nunosousa/DC_VGA_Adapter/README.md

# DC_VGA_Adapter
This is a project detailing a Dreamcast VGA circuit adapter to provide VGA video output.
