nunosousa/DC_VGA_Adapter/Hardware/3D Assembly/Dreamcast_VGA_Adapter.FCStd

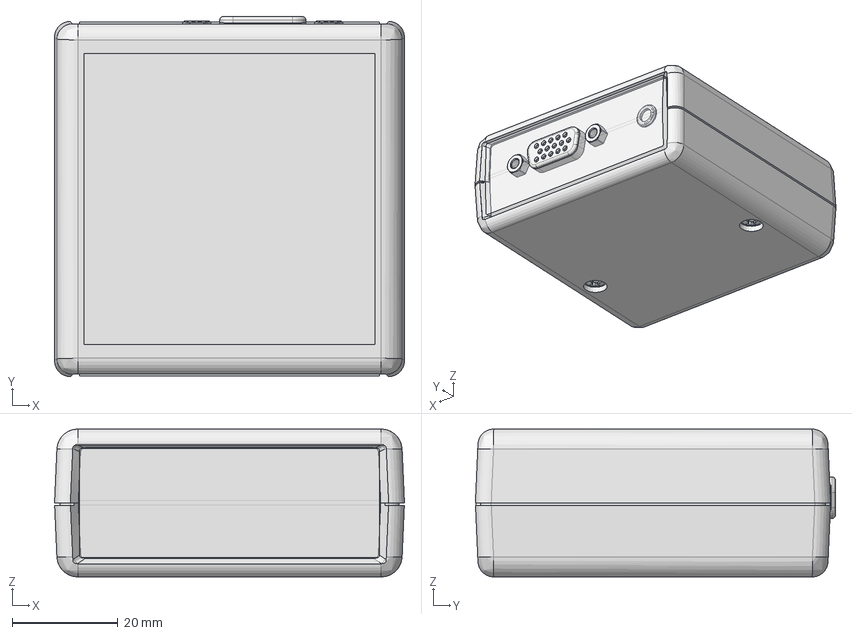
[picture p1: CAD file, 2020-10-10]
Hardware/3D Assembly/Dreamcast_VGA_Adapter.FCStd
66.2 x 68.2 x 28.0 mm
1593K BOTTOM
1593K Top
1593K-L-P-Q-X-Y Flat endplate
1593K-L-P-Q-X-Y Flat endplate001
1593K-L-P-Q-X-Y Contoured Endplate
1593K-L-P-Q-X-Y Contoured Endplate001
SC549 (screw #4X 3_4' OH)
SC549 (screw #4X 3_4' OH)001
1593K PCB
Pcb_5eb8
J1_CUI_DEVICES_SJ1_3533NG_5F7F81FF[2]
U2_SOT_363_SC_70_6_5F7EE279
U1_SOIC_8_39x49mm_P127mm_5F80D54B
SW1_SW_DIP_SPSTx02_Slide_978x726mm_W762mm_P254mm_5F7EE249
R16_R_0805_2012Metric_5F7EE1F0
R15_R_0805_2012Metric_5F7EE1DF
R11_R_0805_2012Metric_5F7EE19B
R10_R_0805_2012Metric_5F7EE18A
R9_R_0805_2012Metric_5F7EE179
R8_R_0805_2012Metric_5F7EE168
R7_R_0805_2012Metric_5F7EE157
R6_R_0805_2012Metric_5F81AA12
R5_R_0805_2012Metric_5F7EE135
R4_R_0805_2012Metric_5F7EE124
R3_R_0805_2012Metric_5F80C6F6
R2_R_0805_2012Metric_5F7FEECB
R1_R_0805_2012Metric_5F7EE0F1
J3_IDC_Header_2x08_P254mm_Vertical_5F7EE0E0
J2_K61X-E15S-NJ_rA4_5F7EE0B2
FB1_L_0805_2012Metric_5F7EE05C
C21_C_0805_2012Metric_5F7EE04B
C20_C_0805_2012Metric_5F7EE03A
C19_C_0805_2012Metric_5F7EE029
C18_C_0805_2012Metric_5F7EE018
C17_C_0805_2012Metric_5F7EE007
C16_C_0805_2012Metric_5F7EDFF6
C15_C_0805_2012Metric_5F7EDFE5
C11_C_0805_2012Metric_5F7EDFA1
C10_C_0805_2012Metric_5F7EDF90
C9_C_0805_2012Metric_5F7EDF7F
C8_CP_EIA_3528_21_Kemet_B_5F818F46
C7_C_0805_2012Metric_5F7EDF5B
C3_CP_Radial_D80mm_P350mm_5F7FE0AD
C2_CP_Radial_D80mm_P350mm_5F7FEB00
C1_CP_Radial_D80mm_P350mm_5F7FE8D8
R14_R_0805_2012Metric_5F7EE1CE
R13_R_0805_2012Metric_5F7EE1BD
R12_R_0805_2012Metric_5F7EE1AC
C6_C_0805_2012Metric_5F7FE810
C5_C_0805_2012Metric_5F7FEA38
C4_C_0805_2012Metric_5F7FE7E0
