nunosousa/DC_VGA_Adapter/Hardware/3D Assembly/1593K.stp

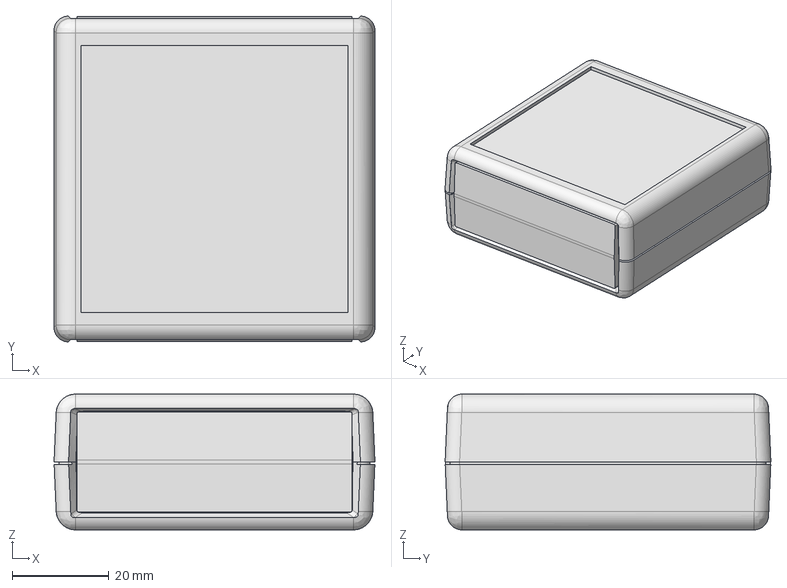
[picture p2: CAD file, 2020-10-10]
Hardware/3D Assembly/1593K.stp
66.2 x 67.2 x 28.0 mm
1593K BOTTOM
1593K Top
1593K-L-P-Q-X-Y Flat endplate x 2
1593K-L-P-Q-X-Y Contoured Endplate x 2
1593K PCB
