nunosousa/DC_VGA_Adapter/Hardware/3D Assembly/holes.pdf

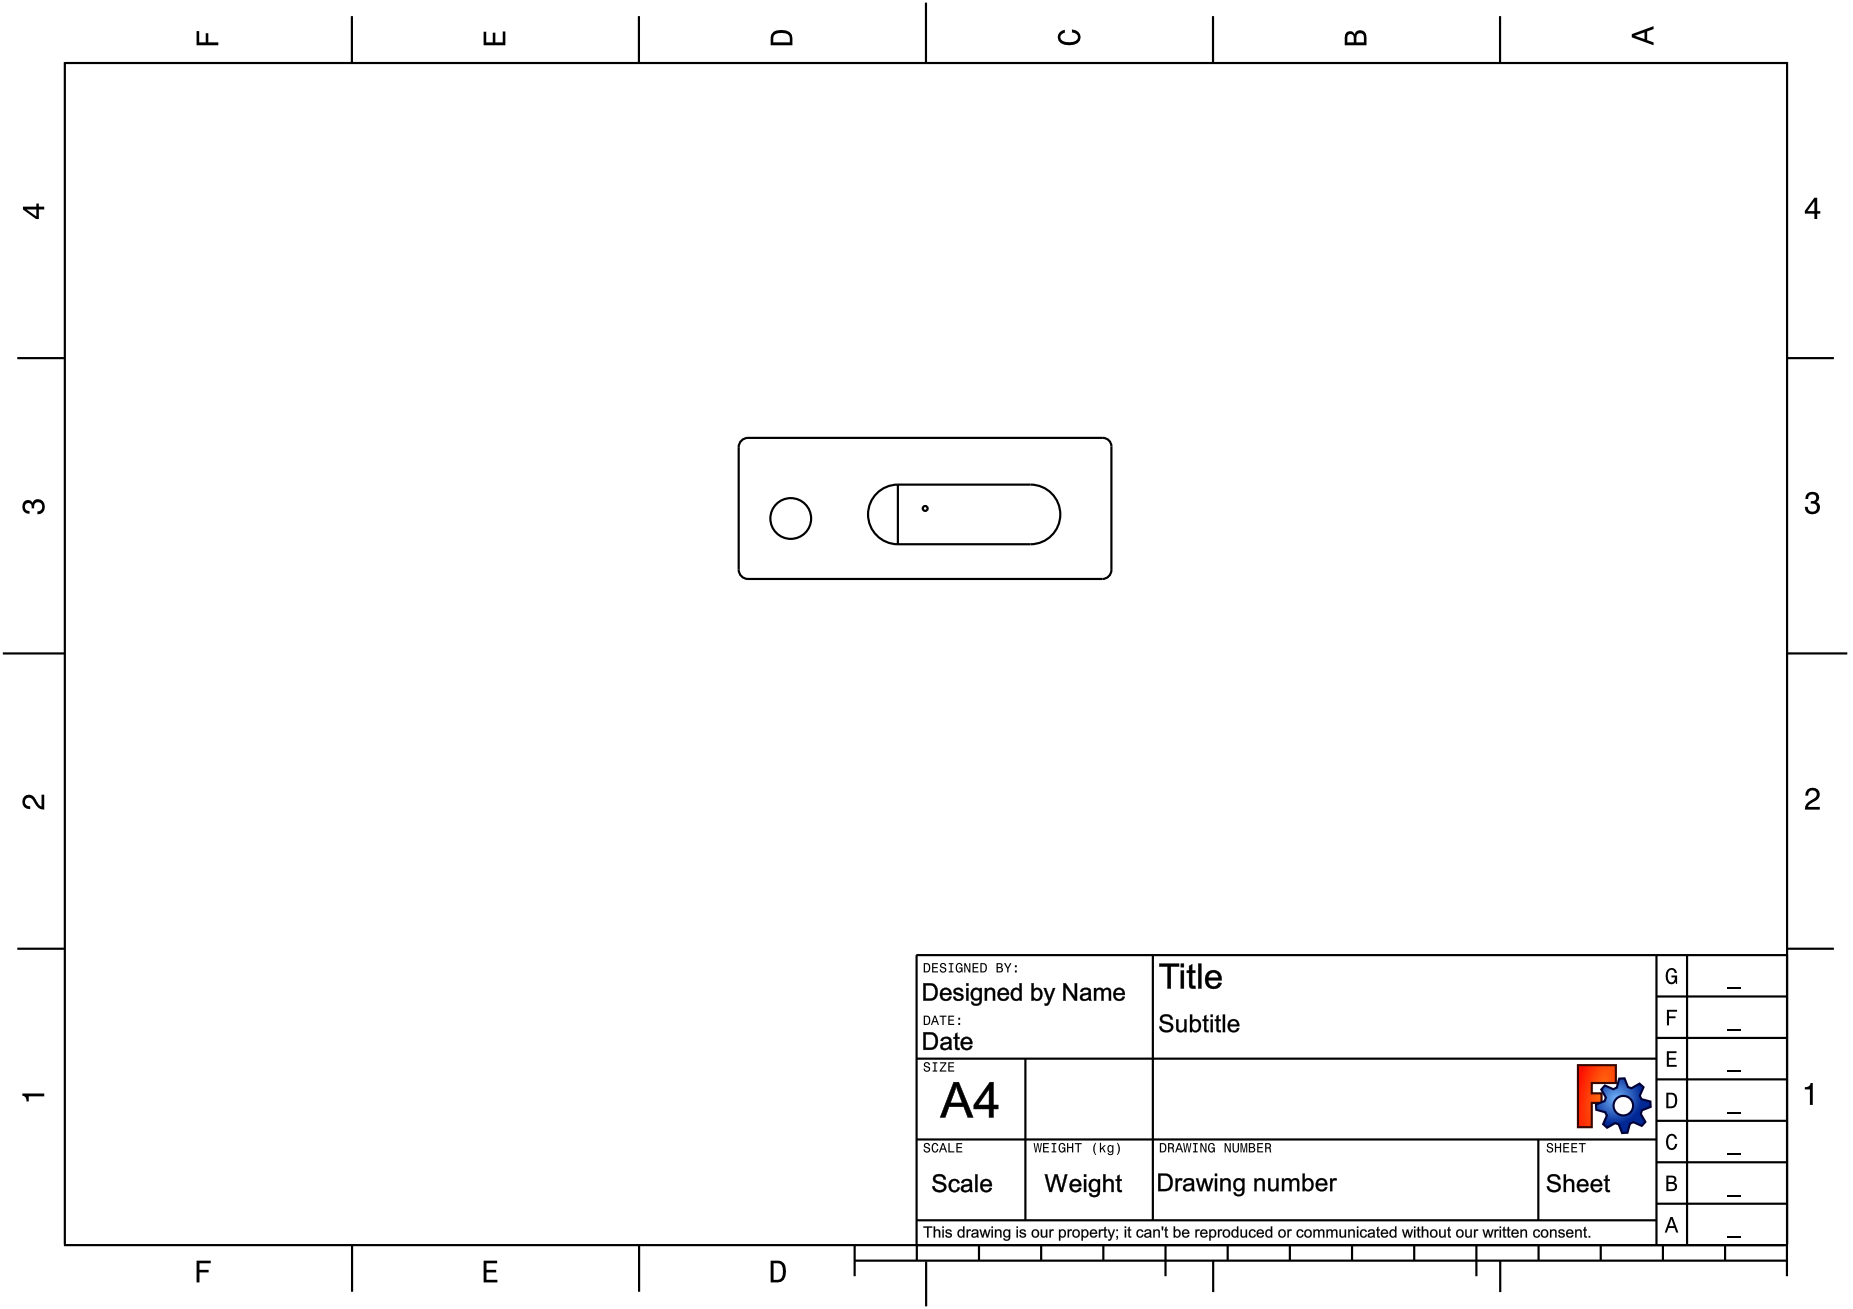
[picture p3: page 1]
