nunosousa/DC_VGA_Adapter/Hardware/Dreamcast_VGA_Adapter.kicad_pcb

## KiCad design Hardware/Dreamcast_VGA_Adapter.kicad_pcb (2024-04-14)

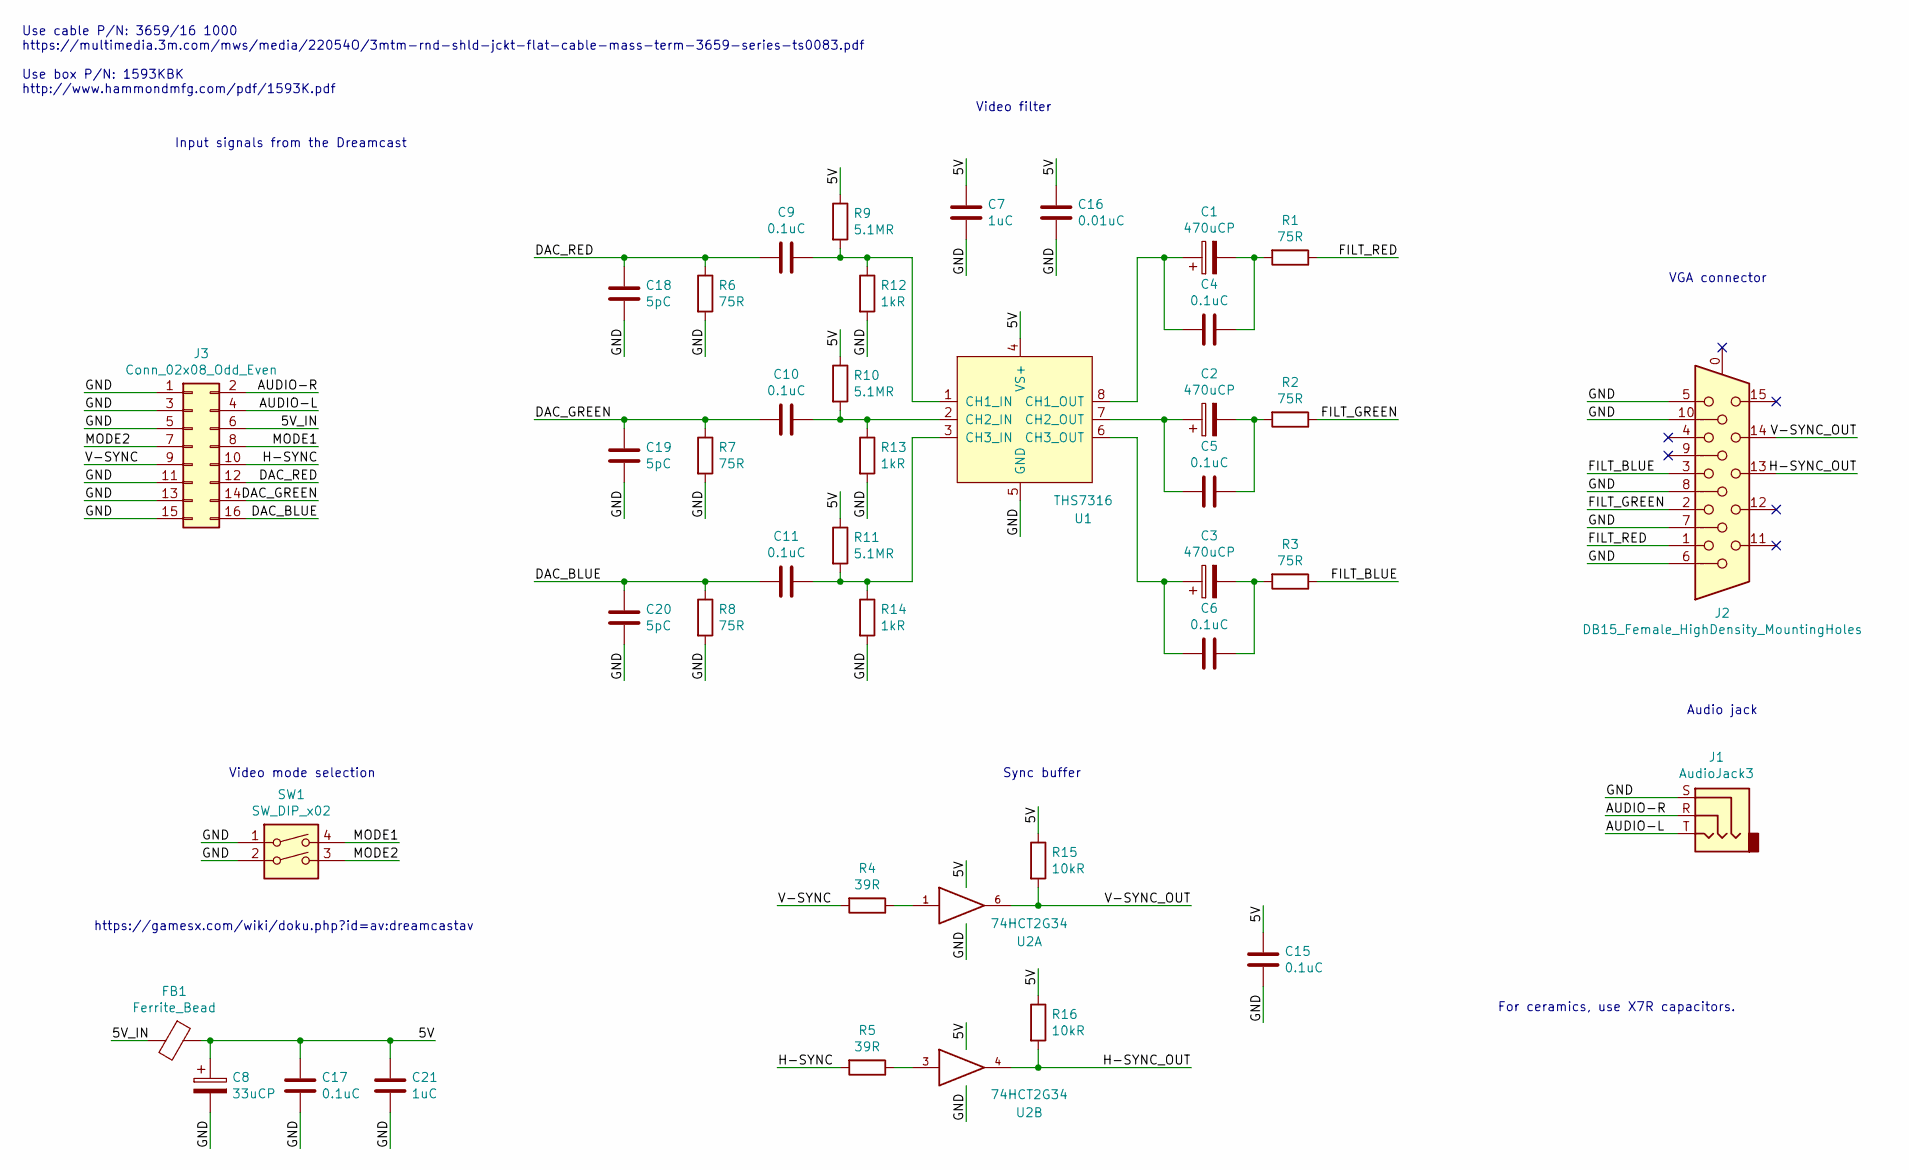
[picture p4: schematic Dreamcast_VGA_Adapter.kicad_sch]

Parts:
C1, C2, C3: 470uCP; CP_Radial_D8.0mm_P3.50mm; Manufacturer Part Number 16ZLH470MEFCT78X11.5
C4, C5, C6, C9, C10, C11, C15, C17: 0.1uC; C_0805_2012Metric_Pad1.15x1.40mm_HandSolder; Manufacturer Part Number AC0805KRX7R7BB104
C7, C21: 1uC; C_0805_2012Metric_Pad1.15x1.40mm_HandSolder; Manufacturer Part Number CC0805MKX7R7BB105
C8: 33uCP; CP_EIA-3528-21_Kemet-B_Pad1.50x2.35mm_HandSolder; Manufacturer Part Number TAJB336K006RNJ
C16: 0.01uC; C_0805_2012Metric_Pad1.15x1.40mm_HandSolder; Manufacturer Part Number CC0805KRX7R9BB103
C18, C19, C20: 5pC; C_0805_2012Metric_Pad1.15x1.40mm_HandSolder; Manufacturer Part Number 08055A5R0CAT2A
FB1: Ferrite_Bead; L_0805_2012Metric_Pad1.15x1.40mm_HandSolder; Manufacturer Part Number BLM21SP471SH1D
J1: AudioJack3; Jack_3.5mm_CUI_SJ1-3533NG_Horizontal; Manufacturer Part Number SJ1-3533NG
J2: DB15_Female_HighDensity_MountingHoles; DSUB-15-HD_Female_Horizontal_P2.29x1.98mm_EdgePinOffset3.03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; Manufacturer Part Number K61X-E15S-NJ
J3: Conn_02x08_Odd_Even; IDC-Header_2x08_P2.54mm_Vertical; Manufacturer Part Number 7816-0000PR
R1, R2, R3, R6, R7, R8: 75R; R_0805_2012Metric_Pad1.15x1.40mm_HandSolder; Manufacturer Part Number KTR10EZPF75R0
R4, R5: 39R; R_0805_2012Metric_Pad1.15x1.40mm_HandSolder; Manufacturer Part Number RC0805FR-0739RL
R9, R10, R11: 5.1MR; R_0805_2012Metric_Pad1.15x1.40mm_HandSolder; Manufacturer Part Number KTR10EZPF5104
R12, R13, R14: 1kR; R_0805_2012Metric_Pad1.15x1.40mm_HandSolder; Manufacturer Part Number RC0805FR-071KL
R15, R16: 10kR; R_0805_2012Metric_Pad1.15x1.40mm_HandSolder; Manufacturer Part Number RC0805FR-0710KL
SW1: SW_DIP_x02; SW_DIP_SPSTx02_Slide_9.78x7.26mm_W7.62mm_P2.54mm; Manufacturer Part Number DS01-254-L-02BE
U1: THS7316; SOIC-8_3.9x4.9mm_P1.27mm; Manufacturer Part Number THS7316DR
U2: 74HCT2G34; SOT-363_SC-70-6_Handsoldering; Manufacturer Part Number 74HCT2G34GW,125

Connections:
/5V_IN: FB1.2, J3.6
/AUDIO-L: J1.T, J3.4
/AUDIO-R: J1.R, J3.2
/DAC_BLUE: C11.2, C20.1, J3.16, R8.1
/DAC_GREEN: C10.2, C19.1, J3.14, R7.1
/DAC_RED: C9.2, C18.1, J3.12, R6.1
/FILT_BLUE: J2.3, R3.1
/FILT_GREEN: J2.2, R2.1
/FILT_RED: J2.1, R1.1
/H-SYNC: J3.10, R5.2
/H-SYNC_OUT: J2.13, R16.2, U2.4
/MODE1: J3.8, SW1.4
/MODE2: J3.7, SW1.3
/V-SYNC: J3.9, R4.2
/V-SYNC_OUT: J2.14, R15.2, U2.6
GND: C7.2, C8.2, C15.2, C16.2, C17.2, C18.2, C19.2, C20.2, C21.2, J1.S, J2.5, J2.6, J2.7, J2.8, J2.10, J3.1, J3.3, J3.5, J3.11, J3.13, J3.15, R6.2, R7.2, R8.2, R12.2, R13.2, R14.2, SW1.1, SW1.2, U1.5 (GND), U2.2 (GND)
unnamed: C1.1, C4.2, U1.8 (CH1_OUT)
unnamed: C1.2, C4.1, R1.2
unnamed: C2.1, C5.2, U1.7 (CH2_OUT)
unnamed: C2.2, C5.1, R2.2
unnamed: C3.1, C6.2, U1.6 (CH3_OUT)
unnamed: C3.2, C6.1, R3.2
unnamed: C9.1, R9.2, R12.1, U1.1 (CH1_IN)
unnamed: C10.1, R10.2, R13.1, U1.2 (CH2_IN)
unnamed: C11.1, R11.2, R14.1, U1.3 (CH3_IN)
unnamed: R4.1, U2.1
unnamed: R5.1, U2.3
VCC: C7.1, C8.1, C15.1, C16.1, C17.1, C21.1, FB1.1, R9.1, R10.1, R11.1, R15.1, R16.1, U1.4 (VS+), U2.5 (VCC)

Notes on the sheet:
Video mode selection
Video filter
For ceramics, use X7R capacitors.
Audio jack
Use cable P/N: 3659/16 1000 https://multimedia.3m.com/mws/media/22054O/3mtm-rnd-shld-jckt-flat-cable-mass-term-3659-series-ts0083.pdf Use box P/N: 1593KBK http://www.hammondmfg.com/pdf/1593K.pdf
Sync buffer
Input signals from the Dreamcast
https://gamesx.com/wiki/doku.php?id=av:dreamcastav
VGA connector

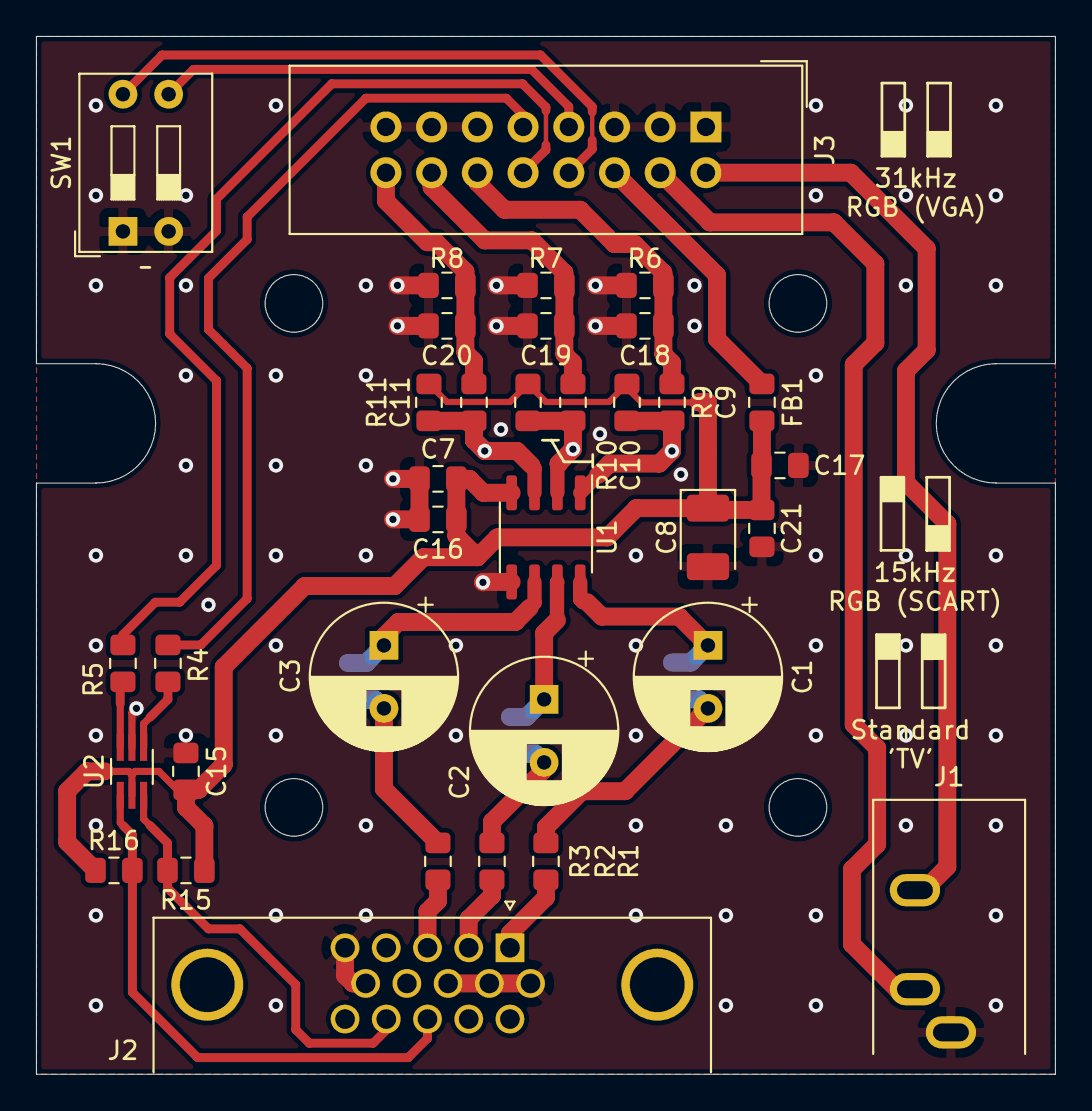
[picture p5: board Dreamcast_VGA_Adapter.kicad_pcb from above]

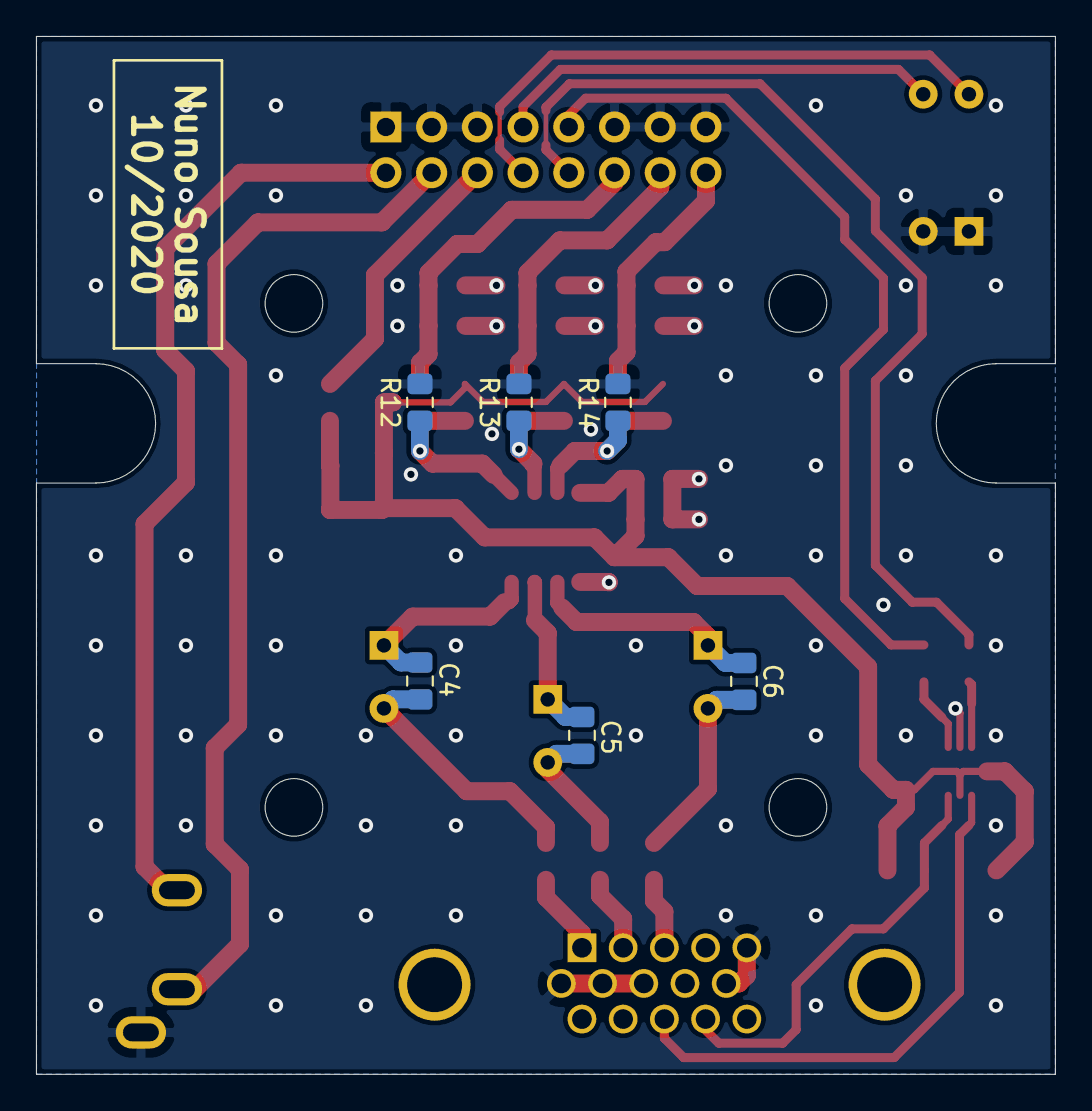
[picture p6: board Dreamcast_VGA_Adapter.kicad_pcb from below]

Board: 2 copper layers, 56.6 x 57.7 mm, 41 parts (6 on the bottom side), 28 nets.
