nunosousa/DC_VGA_Adapter/(commit log)

2020-09-19 Initial commit.
    [Dreamcast_VGA_Adapter.kicad_pcb, Dreamcast_VGA_Adapter.sch]
2020-10-07 Progressed circuit design.
    [Dreamcast_VGA_Adapter.kicad_pcb, Dreamcast_VGA_Adapter.sch]
2020-10-09 Generated gerbers.
    [Dreamcast_VGA_Adapter.kicad_pcb]
2020-10-10 Created 3D model
    [1593K.stp, 3D assembly.FCStd, Dreamcast_VGA_Adapter.kicad_pcb]
2020-10-10 Updated 3d model.
    [3D assembly.FCStd]
2020-10-10 Revert "Updated 3d model."
    This reverts commit c74a3e178eb67756c56d84720efd85ba3459a0e9.
    [3D assembly.FCStd]
2020-10-10 Revert "Created 3D model"
    This reverts commit 1b23ede2aa55525ab1088a1304cc43113caee66c.
    [1593K.stp, 3D assembly.FCStd, Dreamcast_VGA_Adapter.kicad_pcb]
2020-10-10 Moved audio jack.
    [Dreamcast_VGA_Adapter.kicad_pcb]
2020-10-10 Created 3D assembly.
    [1593K.stp, Dreamcast_VGA_Adapter.FCStd]
2020-10-10 Progressed 3D model.
    [Dreamcast_VGA_Adapter.FCStd]
2020-10-10 Updated 3D design.
    [Dreamcast_VGA_Adapter.FCStd, Dreamcast_VGA_Adapter.kicad_pcb]
2020-10-10 Updated PCB.
    [Dreamcast_VGA_Adapter.kicad_pcb]
2020-10-10 Updated 3D assembly.
    [Dreamcast_VGA_Adapter.FCStd]
2024-04-14 Upgraded from Kicad 5 to Kicad 8.
    [Dreamcast_VGA_Adapter.kicad_pcb, Dreamcast_VGA_Adapter.kicad_sch]
